corounum/cpx-logging-shield/pinouts/official.jpg

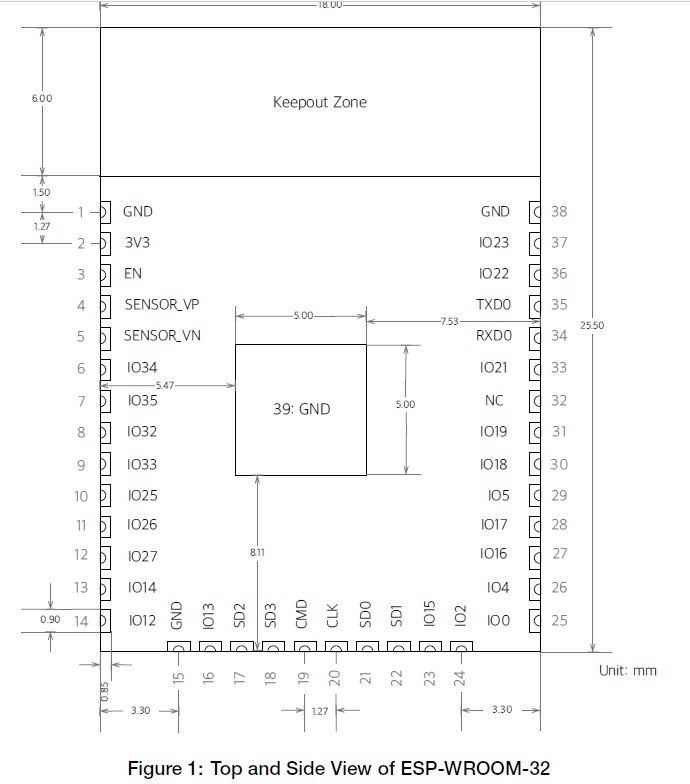
pinouts/official.jpg
