corounum/cpx-logging-shield/hardware/cpx-wroom32d.brd

## EAGLE design hardware/cpx-wroom32d.brd (2019-06-23)

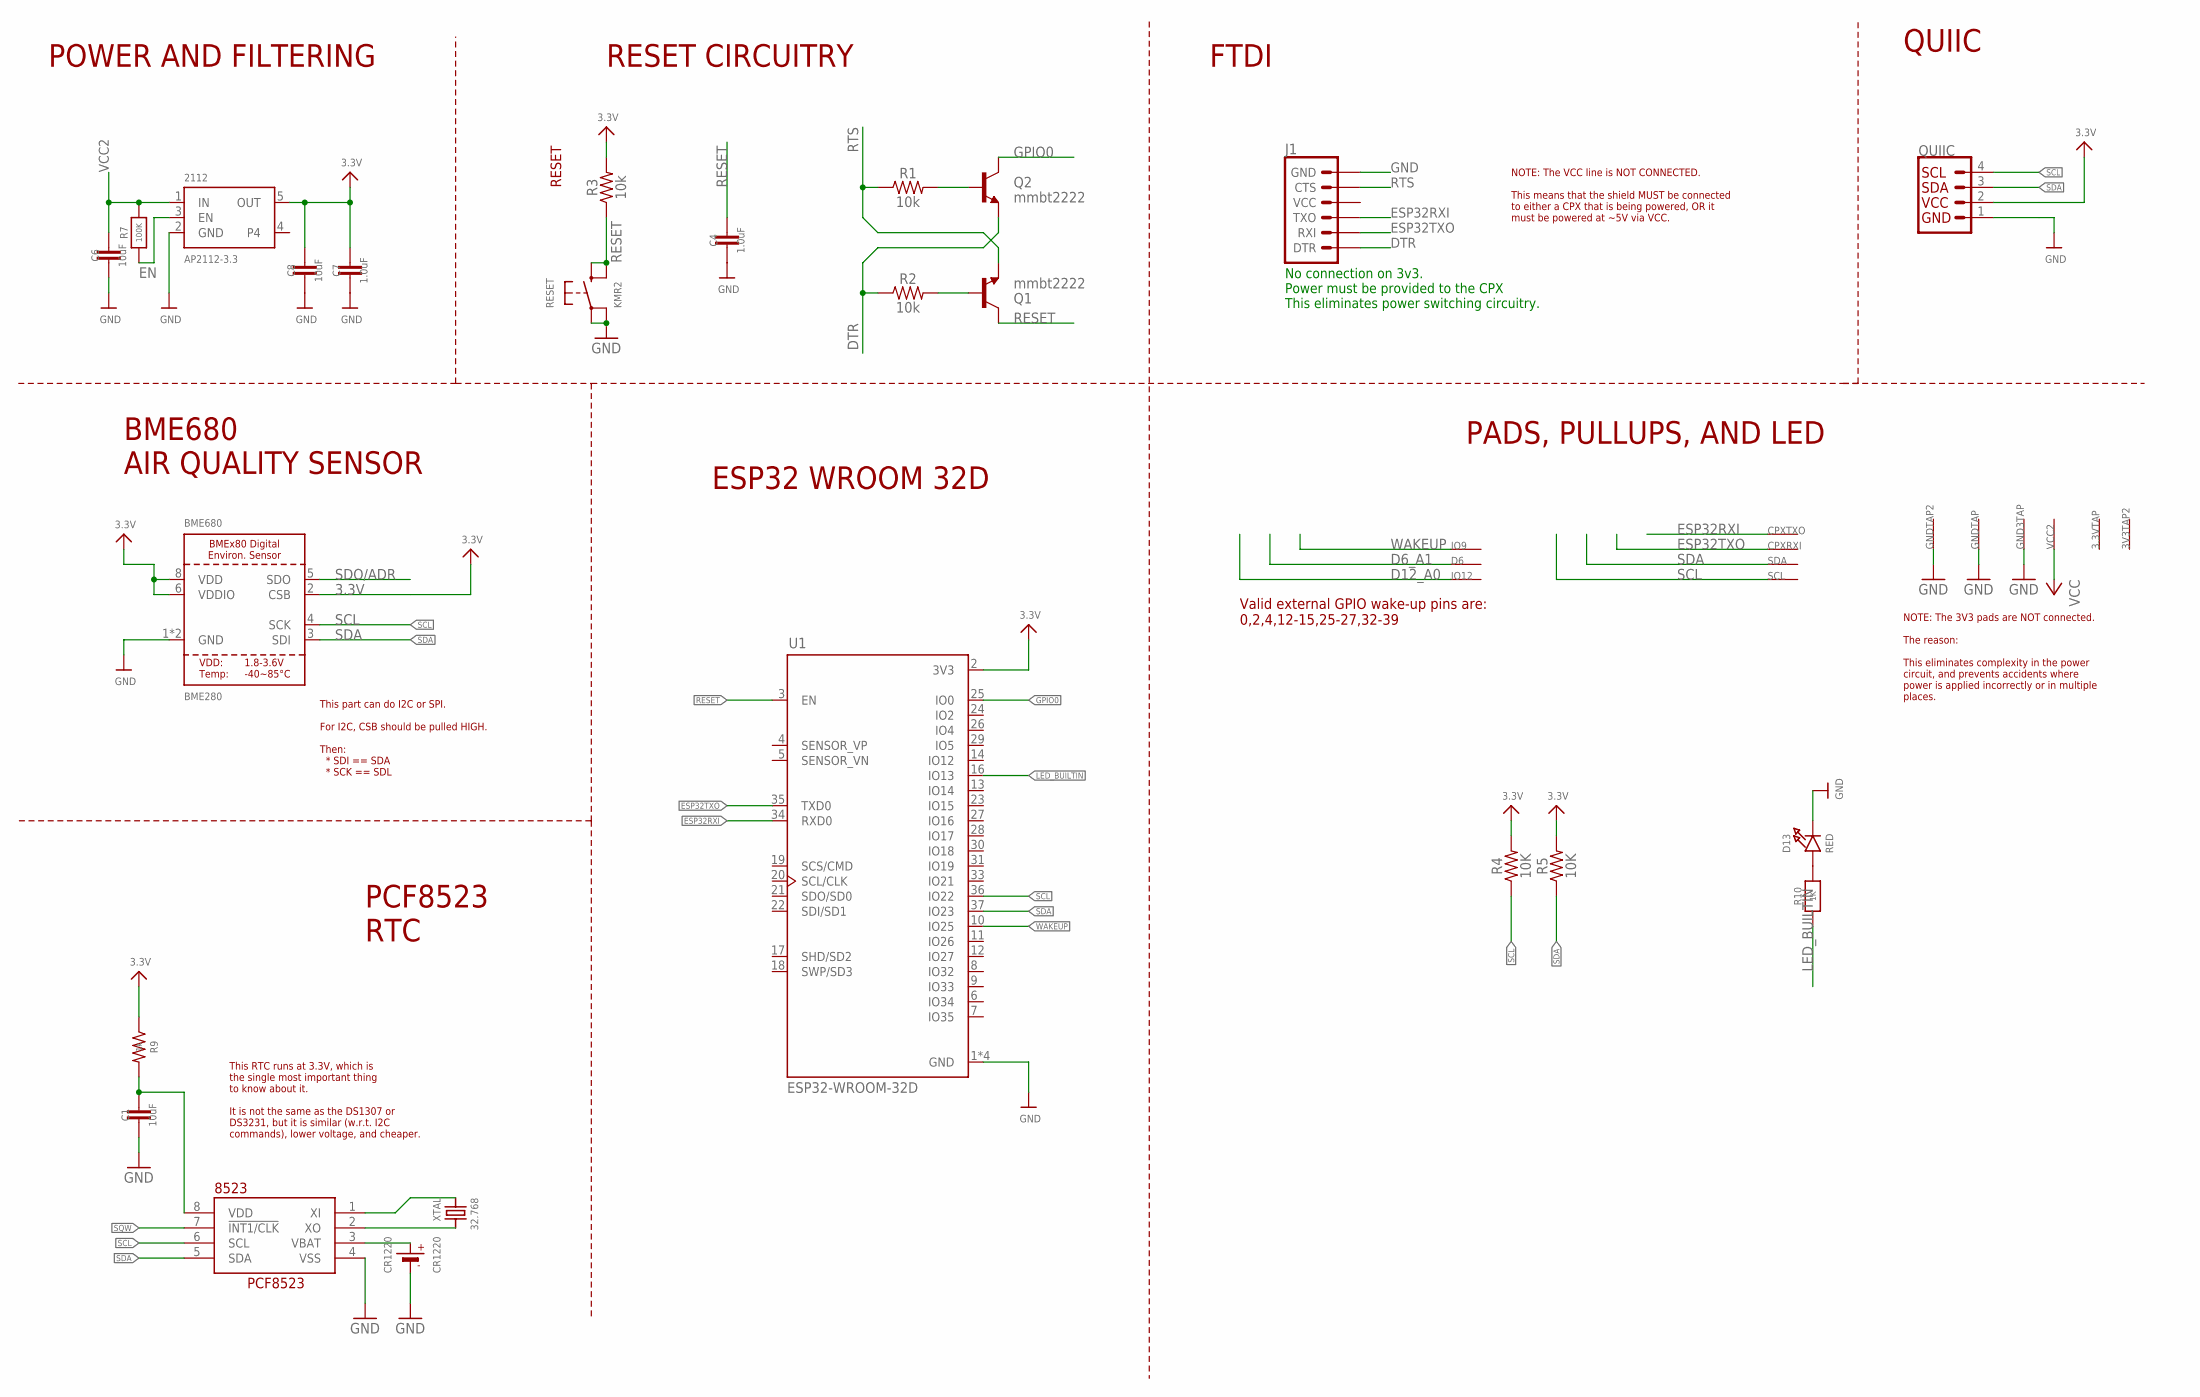
[picture p2: schematic cpx-wroom32d.sch]

Parts:
3.3VTAP, 3V3TAP2: SEWTAP-ALLIGATOR; SEWALLI
2112: AP2112-3.3; SOT23-5
8523: RTC_PCF8523T; SOIC8_150MIL
BME680: BME280
C1, C6, C8: 10uF; 0603
C4, C7: 1.0uF; 0603
CPXRXI: SEWTAP-ALLIGATOR; SEWALLI
CPXTXO: SEWTAP-ALLIGATOR; SEWALLI
CR1220: CR1220
D6: SEWTAP-ALLIGATOR; SEWALLI
D13: RED; CHIPLED_0805_NOOUTLINE
GND3TAP: SEWTAP-ALLIGATOR; SEWALLI
GNDTAP, GNDTAP2: SEWTAP-ALLIGATOR; SEWALLI
IO9, IO12: SEWTAP-ALLIGATOR; SEWALLI
J1: 6_PIN_SERIAL_TARGETRA_SMT; 6_PIN_SERIAL_TARGET_SIDE_RA_SMT
Q1, Q2: mmbt2222; SOT23-3
QUIIC: QWIIC_CONNECTORJS-1MM; 1X04_1MM_RA
R1, R2, R3: 10k; 0603
R4, R5: 10K; 0603
R7: 100K; 0603-NO
R9: 1k; 0603
R10: 1K; 0603-NO
RESET: KMR2; BTN_KMR2_4.6X2.8
SCL: SEWTAP-ALLIGATOR; SEWALLI
SDA: SEWTAP-ALLIGATOR; SEWALLI
U1: ESP32-WROOM-32D; MODULE_ESP32-WROOM-32D
VCC2: SEWTAP-ALLIGATOR; SEWALLI
XTAL: 32.768; CRYSTAL_8X3.8

Connections:
3.3V: 2112.5 (OUT), BME680.2 (CSB), BME680.6 (VDDIO), BME680.8 (VDD), C7.1, C8.1, QUIIC.2 (VCC), R3.2, R4.2, R5.2, R9.1, U1.2 (3V3)
CLKVCC: 8523.8 (VDD), C1.1, R9.2
D6_A1: D6.P$1
D12_A0: IO12.P$1
DTR: J1.1 (DTR), Q2.2 (E), R2.1
EN: 2112.3 (EN), R7.1
ESP32RXI: CPXTXO.P$1, J1.2 (TXO), U1.34 (RXD0)
ESP32TXO: CPXRXI.P$1, J1.3 (RXI), U1.35 (TXD0)
GND: 2112.2 (GND), 8523.4 (VSS), BME680.1 (GND), BME680.7 (GND), C1.2, C4.2, C6.2, C7.2, C8.2, CR1220.-, D13.C, GND3TAP.P$1, GNDTAP.P$1, GNDTAP2.P$1, J1.6 (GND), QUIIC.1 (GND), RESET.A, RESET.A' (P1), U1.1 (GND), U1.15 (GND), U1.38 (GND), U1.39 (GND)
GPIO0: Q2.3 (C), U1.25 (IO0)
LED_BUILTIN: R10.1, U1.16 (IO13)
unnamed: D13.A, R10.2
unnamed: Q1.1 (B), R2.2
unnamed: Q2.1 (B), R1.2
RESET: C4.1, Q1.3 (C), R3.1, RESET.B (S), RESET.B' (S1), U1.3 (EN)
RTS: J1.5 (CTS), Q1.2 (E), R1.1
SCL: 8523.6 (SCL), BME680.4 (SCK), QUIIC.4 (SCL), R4.1, SCL.P$1, U1.36 (IO22)
SDA: 8523.5 (SDA), BME680.3 (SDI), QUIIC.3 (SDA), R5.1, SDA.P$1, U1.37 (IO23)
SDO/ADR: BME680.5 (SDO)
SQW: 8523.7 (!INT1/CLK)
VBAT1: 8523.3 (VBAT), CR1220.+$1 (+)
VCC: VCC2.P$1
VCC2: 2112.1 (IN), C6.1, R7.2
WAKEUP: IO9.P$1, U1.10 (IO25)
XI: 8523.1 (XI), XTAL.P$1 (1)
XO: 8523.2 (XO), XTAL.P$4 (2)

Notes on the sheet:
RESET
No connection on 3v3. Power must be provided to the CPX This eliminates power switching circuitry.
POWER AND FILTERING
RESET CIRCUITRY
FTDI
ESP32 WROOM 32D
BME680 AIR QUALITY SENSOR
PCF8523 RTC
PADS, PULLUPS, AND LED
This part can do I2C or SPI. For I2C, CSB should be pulled HIGH. Then: * SDI == SDA * SCK == SDL
This RTC runs at 3.3V, which is the single most important thing to know about it. It is not the same as the DS1307 or DS3231, but it is similar (w.r.t. I2C commands), lower voltage, and cheaper.
NOTE: The VCC line is NOT CONNECTED. This means that the shield MUST be connected to either a CPX that is being powered, OR it must be powered at ~5V via VCC.
NOTE: The 3V3 pads are NOT connected. The reason: This eliminates complexity in the power circuit, and prevents accidents where power is applied incorrectly or in multiple places.
QUIIC
Valid external GPIO wake-up pins are: 0,2,4,12-15,25-27,32-39

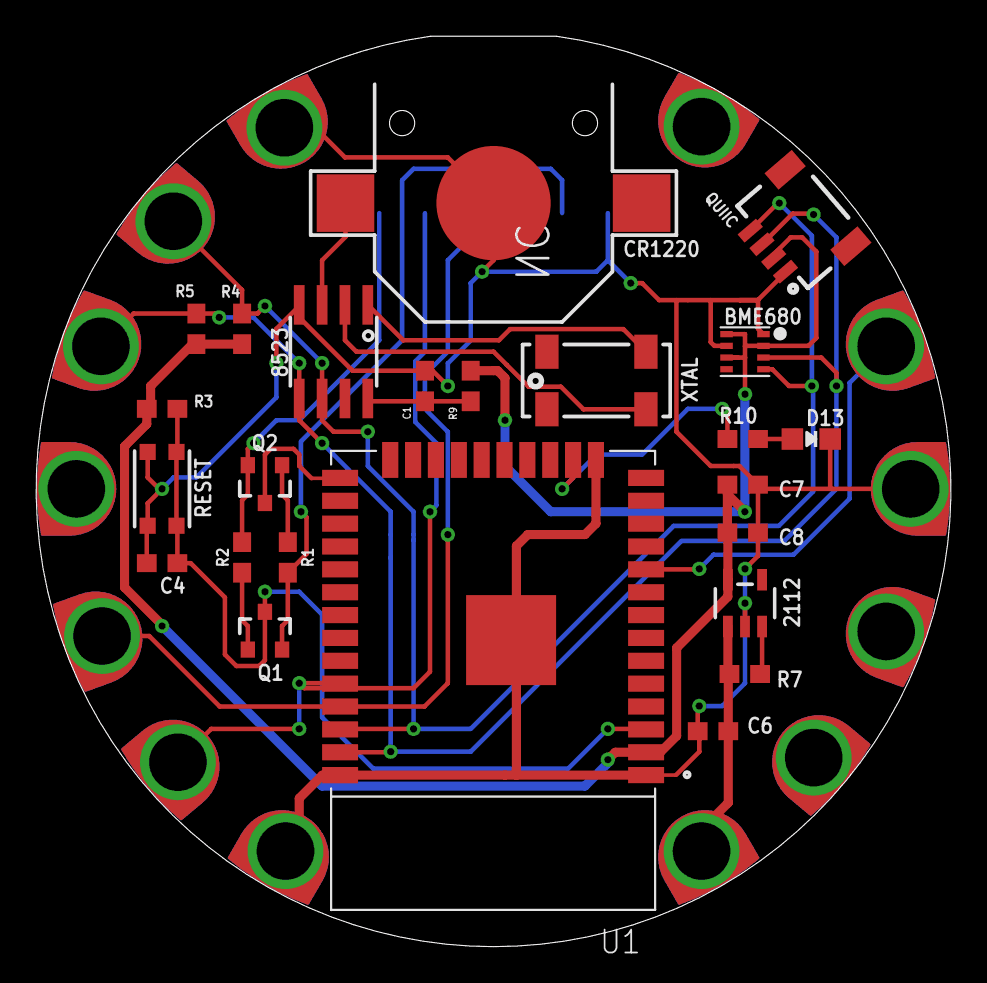
[picture p3: board cpx-wroom32d.brd from above]

Board: 2 copper layers, 50.8 x 50.6 mm, 38 parts (1 on the bottom side), 21 nets.
