corounum/cpx-logging-shield/hardware/sources/Adafruit BME680.brd

## EAGLE design hardware/sources/Adafruit BME680.brd (2019-06-22)

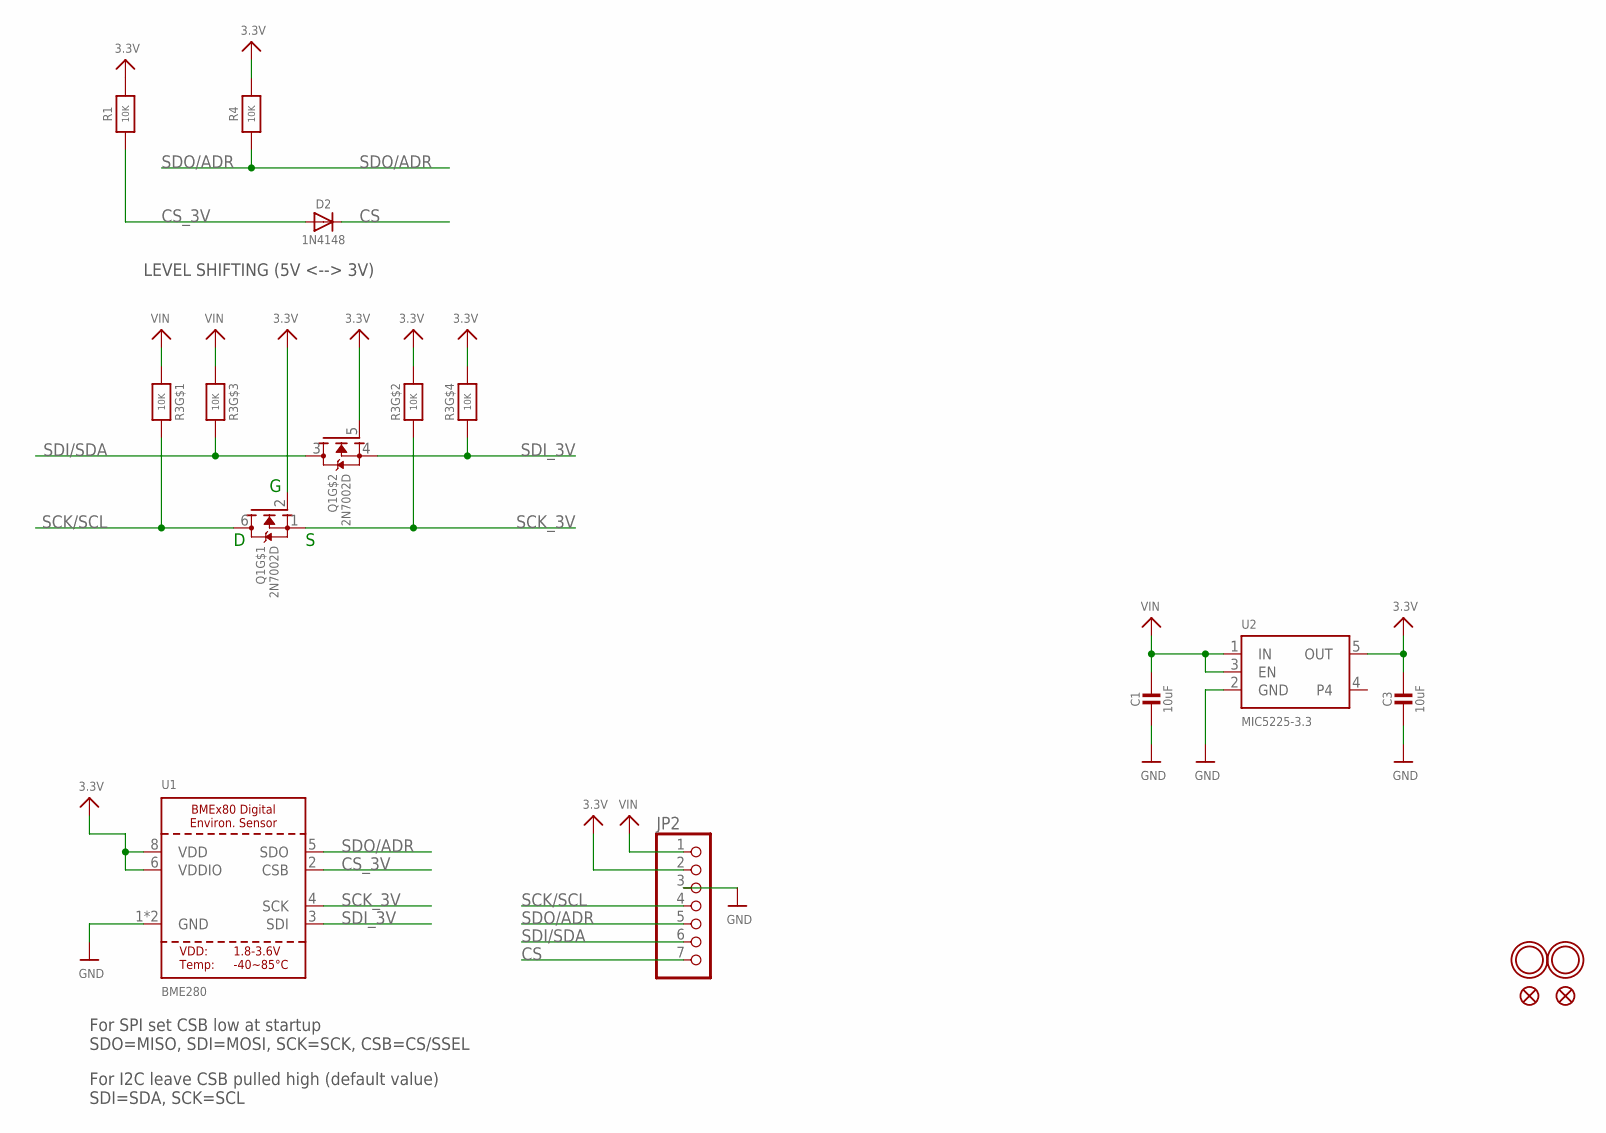
[picture p4: schematic Adafruit BME680.sch]

Parts:
C1, C3: 10uF; 0805-NO
D2: 1N4148; SOD-323
JP2: HEADER-1X770MIL; 1X07_ROUND_70
Q1: 2N7002D; SOT363
R1, R4: 10K; 0603-NO
R3: 10K; RESPACK_4X0603
U1: BME280
U2: MIC5225-3.3; SOT23-5
U$5, U$15: FIDUCIAL_1MM
U$7, U$8: MOUNTINGHOLE2.0; MOUNTINGHOLE_2.0_PLATED

Connections:
3.3V: C3.1, JP2.2, Q1.2 (G), Q1.5 (G), R1.2, R3.2 (1), R3.4 (1), R4.2, U1.6 (VDDIO), U1.8 (VDD), U2.5 (OUT)
CS: D2.C, JP2.7
CS_3V: D2.A, R1.1, U1.2 (CSB)
GND: C1.2, C3.2, JP2.3, U1.1 (GND), U1.7 (GND), U2.2 (GND)
SCK/SCL: JP2.4, Q1.6 (D), R3.8 (2)
SCK_3V: Q1.1 (S), R3.7 (2), U1.4 (SCK)
SDI/SDA: JP2.6, Q1.3 (D), R3.6 (2)
SDI_3V: Q1.4 (S), R3.5 (2), U1.3 (SDI)
SDO/ADR: JP2.5, R4.1, U1.5 (SDO)
VIN: C1.1, JP2.1, R3.1, R3.3 (1), U2.1 (IN), U2.3 (EN)

Notes on the sheet:
For SPI set CSB low at startup SDO=MISO, SDI=MOSI, SCK=SCK, CSB=CS/SSEL
For I2C leave CSB pulled high (default value) SDI=SDA, SCK=SCL
LEVEL SHIFTING (5V <--> 3V)

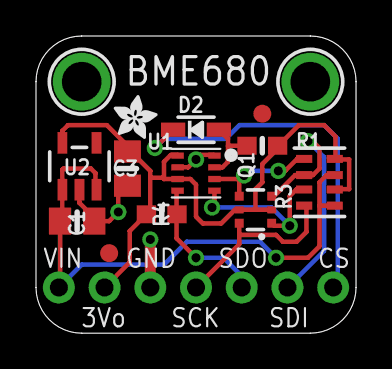
[picture p5: board Adafruit BME680.brd from above]

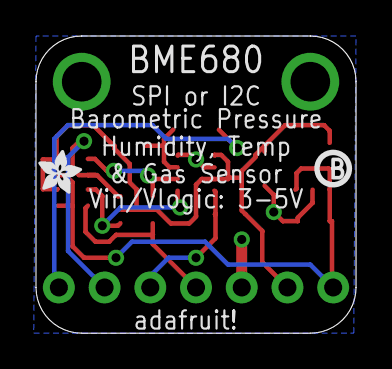
[picture p6: board Adafruit BME680.brd from below]

Board: 2 copper layers, 17.8 x 16.5 mm, 17 parts (2 on the bottom side), 10 nets.

Other parts of the board:
U$2, U$6: ADAFRUIT_2.5MM
U$20: PCBFEAT-REV-040
