corounum/cpx-logging-shield/hardware/sources/Adafruit PCF8523 RTC.brd

## EAGLE design hardware/sources/Adafruit PCF8523 RTC.brd (2019-06-22)

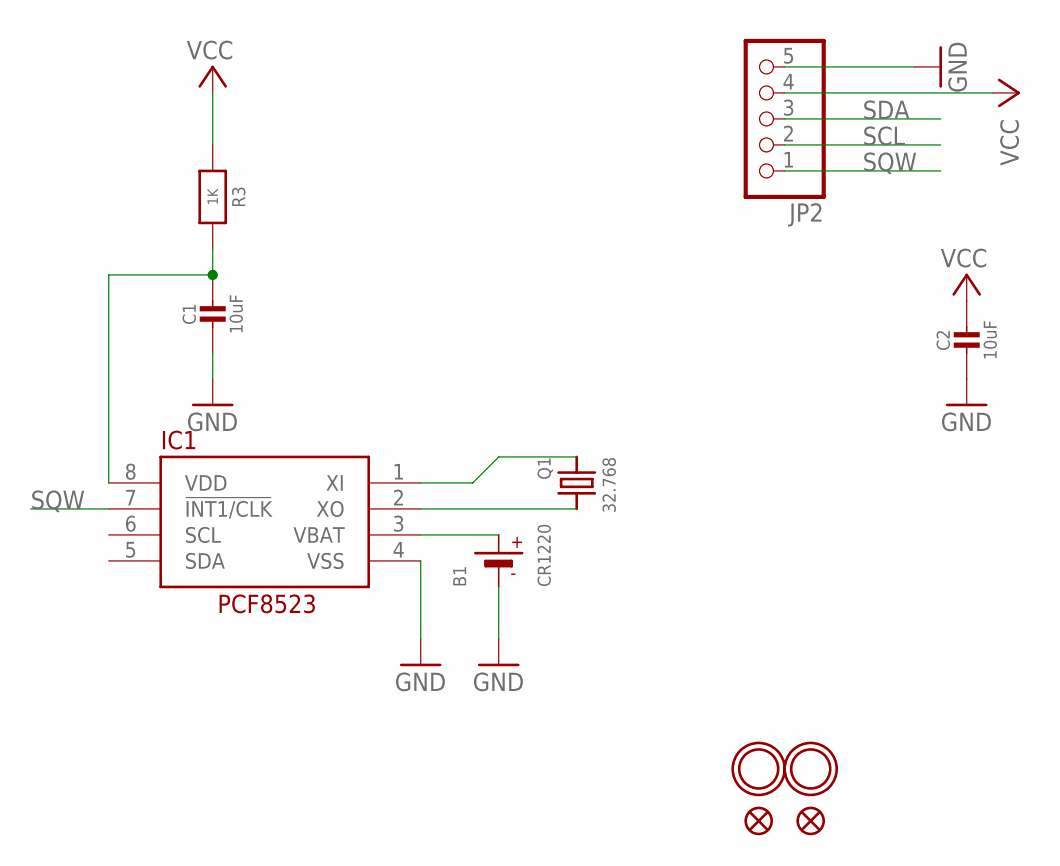
[picture p7: schematic Adafruit PCF8523 RTC.sch]

Parts:
B1: CR1220
C1, C2: 10uF; 0805-NO
FID1, FID2: FIDUCIAL""; FIDUCIAL_1MM
IC1: RTC_PCF8523T; SOIC8_150MIL
JP2: HEADER-1X576MIL; 1X05_ROUND_76
Q1: 32.768; CRYSTAL_8X3.8
R3: 1K; 0805-NO
U$1, U$4: MOUNTINGHOLE2.0; MOUNTINGHOLE_2.0_PLATED

Connections:
GND: B1.-, C1.2, C2.2, IC1.4 (VSS), JP2.5
unnamed: C1.1, IC1.8 (VDD), R3.2
unnamed: IC1.1 (XI), Q1.P$1 (1)
unnamed: IC1.2 (XO), Q1.P$4 (2)
SCL: JP2.2
SDA: JP2.3
SQW: IC1.7 (!INT1/CLK), JP2.1
VBAT: B1.+$1 (+), IC1.3 (VBAT)
VCC: C2.1, JP2.4, R3.1

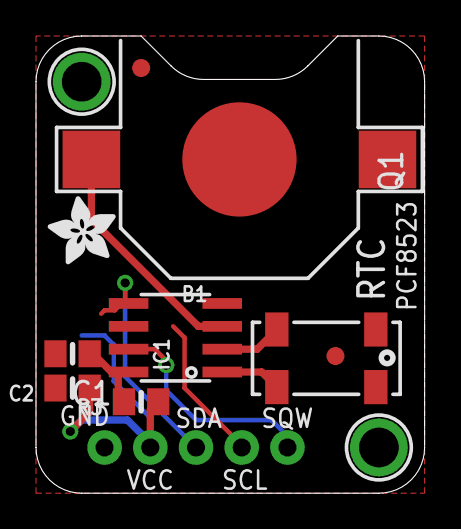
[picture p8: board Adafruit PCF8523 RTC.brd from above]

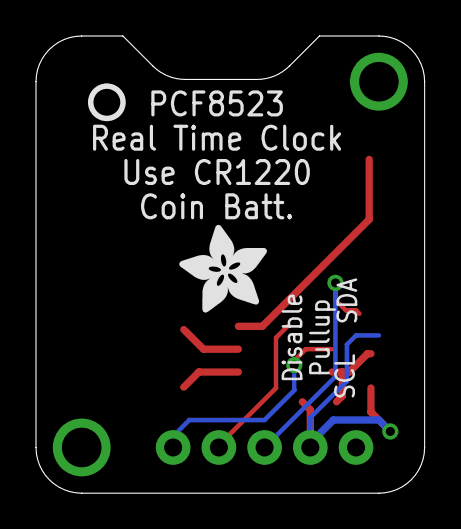
[picture p9: board Adafruit PCF8523 RTC.brd from below]

Board: 2 copper layers, 21.6 x 25.4 mm, 14 parts (2 on the bottom side), 7 nets.

Other parts of the board:
U$2: ADAFRUIT_3.5MM
U$3: PCBFEAT-REV-040
U$5: ADAFRUIT_5MM
