corounum/cpx-logging-shield/hardware/sources/Adafruit AirLift Breakout.brd

## EAGLE design hardware/sources/Adafruit AirLift Breakout.brd (2019-06-22)

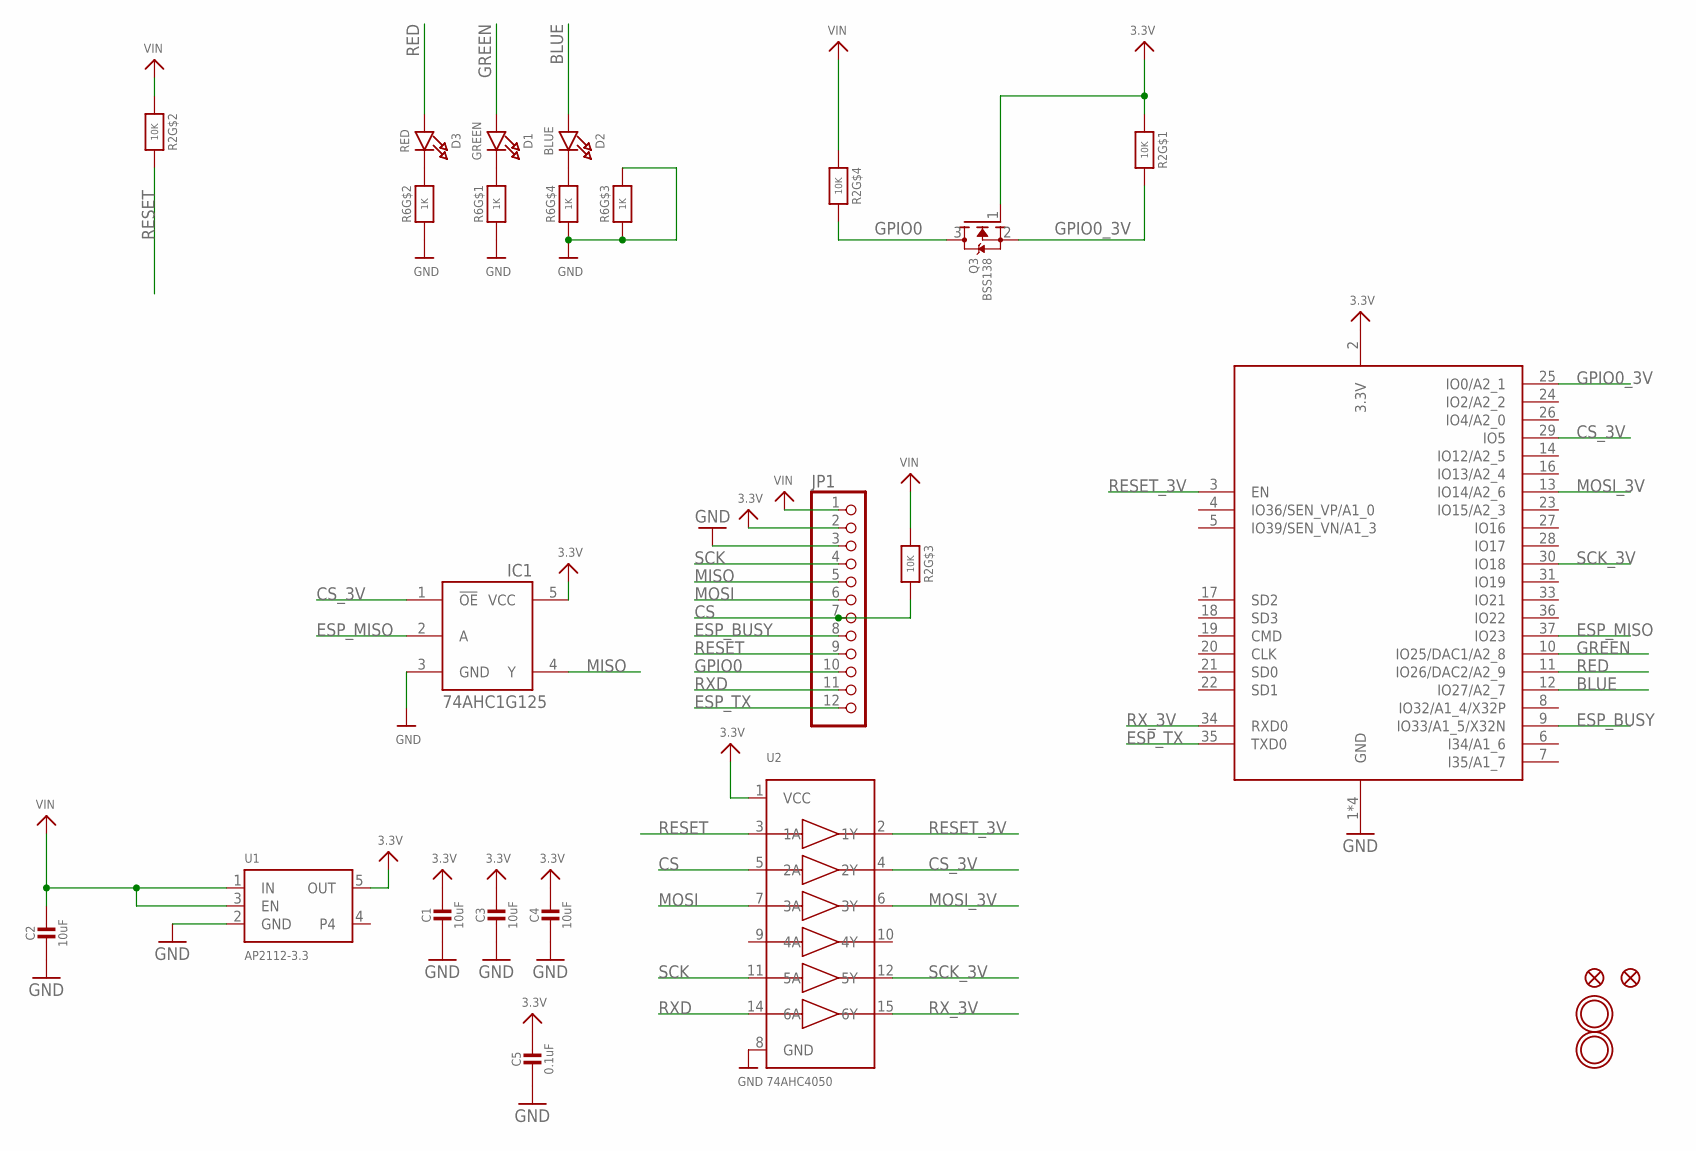
[picture p13: schematic Adafruit AirLift Breakout.sch]

Parts:
C1, C2, C3, C4: 10uF; 0805-NO
C5: 0.1uF; 0603-NO
D1: GREEN; CHIPLED_0603_NOOUTLINE
D2: BLUE; CHIPLED_0603_NOOUTLINE
D3: RED; CHIPLED_0603_NOOUTLINE
FID1, FID3: FIDUCIAL_1MM
IC1: 74AHC1G125; SOT23-5L
JP1: HEADER-1X12; 1X12_ROUND
Q3: BSS138; SOT23-WIDE
R2: 10K; RESPACK_4X0603
R6: 1K; RESPACK_4X0603
U1: AP2112-3.3; SOT23-5
U2: 74AHC4050; TSSOP16
U$15, U$16: MOUNTINGHOLE2.5; MOUNTINGHOLE_2.5_PLATED
X1: ESP32_WROOM32; WROOM32

Connections:
3.3V: C1.1, C3.1, C4.1, C5.1, IC1.5 (VCC), JP1.2, Q3.1 (G), R2.8 (2), U1.5 (OUT), U2.1 (VCC), X1.2 (3.3V)
BLUE: D2.A, X1.12 (IO27/A2_7)
CS: JP1.7, R2.6 (2), U2.5 (2A)
CS_3V: IC1.1 (!OE), U2.4 (2Y), X1.29 (IO5)
ESP_BUSY: JP1.8, X1.9 (IO33/A1_5/X32N)
ESP_MISO: IC1.2 (A), X1.37 (IO23)
ESP_TX: JP1.12, X1.35 (TXD0)
GND: C1.2, C2.2, C3.2, C4.2, C5.2, IC1.3 (GND), JP1.3, R6.1, R6.2 (1), R6.3 (1), R6.4 (1), R6.6 (2), U1.2 (GND), U2.8 (GND), X1.1 (GND), X1.15 (GND), X1.38 (GND), X1.P$1 (GND)
GPIO0: JP1.10, Q3.3 (D), R2.4 (1)
GPIO0_3V: Q3.2 (S), R2.1, X1.25 (IO0/A2_1)
GREEN: D1.A, X1.10 (IO25/DAC1/A2_8)
MISO: IC1.4 (Y), JP1.5
MOSI: JP1.6, U2.7 (3A)
MOSI_3V: U2.6 (3Y), X1.13 (IO14/A2_6)
unnamed: D3.C, R6.7 (2)
unnamed: D1.C, R6.8 (2)
unnamed: D2.C, R6.5 (2)
RED: D3.A, X1.11 (IO26/DAC2/A2_9)
RESET: JP1.9, R2.7 (2), U2.3 (1A)
RESET_3V: U2.2 (1Y), X1.3 (EN)
RXD: JP1.11, U2.14 (6A)
RX_3V: U2.15 (6Y), X1.34 (RXD0)
SCK: JP1.4, U2.11 (5A)
SCK_3V: U2.12 (5Y), X1.30 (IO18)
VIN: C2.1, JP1.1, R2.2 (1), R2.3 (1), R2.5 (2), U1.1 (IN), U1.3 (EN)

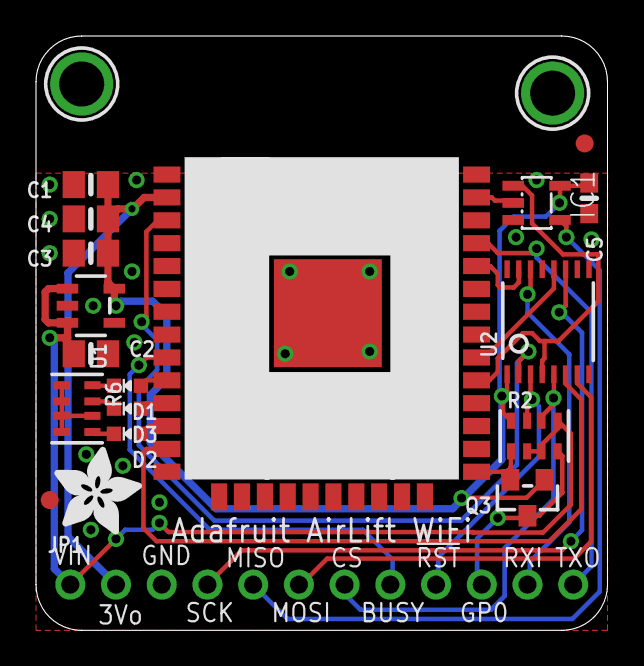
[picture p14: board Adafruit AirLift Breakout.brd from above]

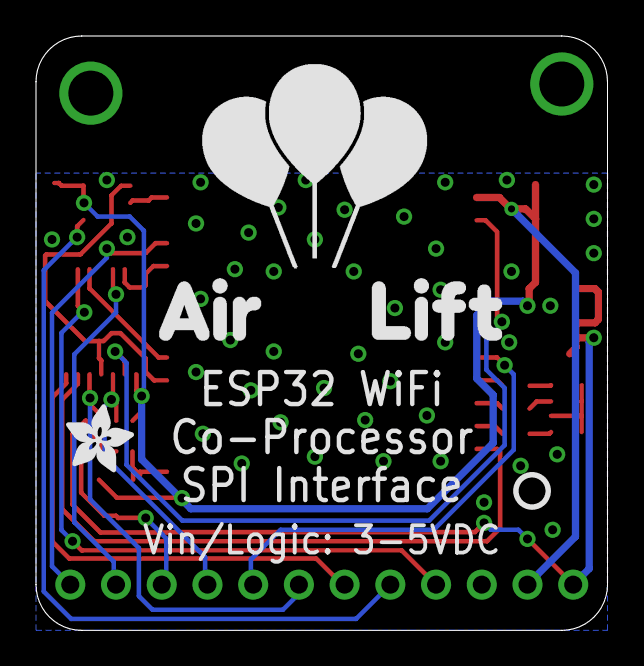
[picture p15: board Adafruit AirLift Breakout.brd from below]

Board: 2 copper layers, 31.8 x 33.0 mm, 24 parts (3 on the bottom side), 25 nets.

Other parts of the board:
U$2: ADAFRUIT_3.5MM
U$13: PCBFEAT-REV-040
U$21: ADAFRUIT_5MM
U$24: AIRLIFT
