corounum/cpx-logging-shield/(commit log)

2019-06-22 First commit.
    This should have been under version control a long time ago.
    [Adafruit AirLift Breakout.brd, Adafruit AirLift Breakout.sch, Adafruit HUZZAH32 ESP32 Feather.brd, Adafruit HUZZAH32 ESP32 Feather.sch, cpx-wroom32d.brd, cpx-wroom32d.sch, cpx.brd, cpx.sch]
2019-06-22 About to remove some connections to the CPX.
    [Adafruit PCF8523 RTC.brd, Adafruit PCF8523 RTC.sch, cpx-wroom32d.brd, cpx-wroom32d.sch]
2019-06-22 Looks goo.
    [Adafruit BME680.brd, Adafruit BME680.sch, cpx-wroom32d.brd, cpx-wroom32d.sch]
2019-06-22 Cleaned up labeling, schematic.
    [cpx-wroom32d.brd, cpx-wroom32d.sch]
2019-06-22 Removing the old version.
    [cpx.brd, cpx.sch]
2019-06-23 Forgot .gitignore, updates.
    * Added a wakeup line to A2 on the CPX.
    Toggling this is to trigger the external interrupt on
    the ESP32. This seems better than playing games with RX/TX
    * Moved BME680 a bit, to get it away from the QUIIC connector.
    * Exploring sleep. Need to think about what I want for a serial protocol. Line-oriented? Byte-oriented?
    I'd rather we were using I2C for this, but for the team, we're using Python.
    [cpx-wroom32d.brd, cpx-wroom32d.sch]
